TommanCZ/herni-joystick/README.md

# herni-joystick
Maturitní projekt Tomáše Partla v předmětu informatika na Gymnáziu Jana Keplera.
