TommanCZ/herni-joystick/dokumentace.pdf

# GYMNASIUM JANA KEPLERA

### Parléˇrova 2/118, 169 00 Praha 6

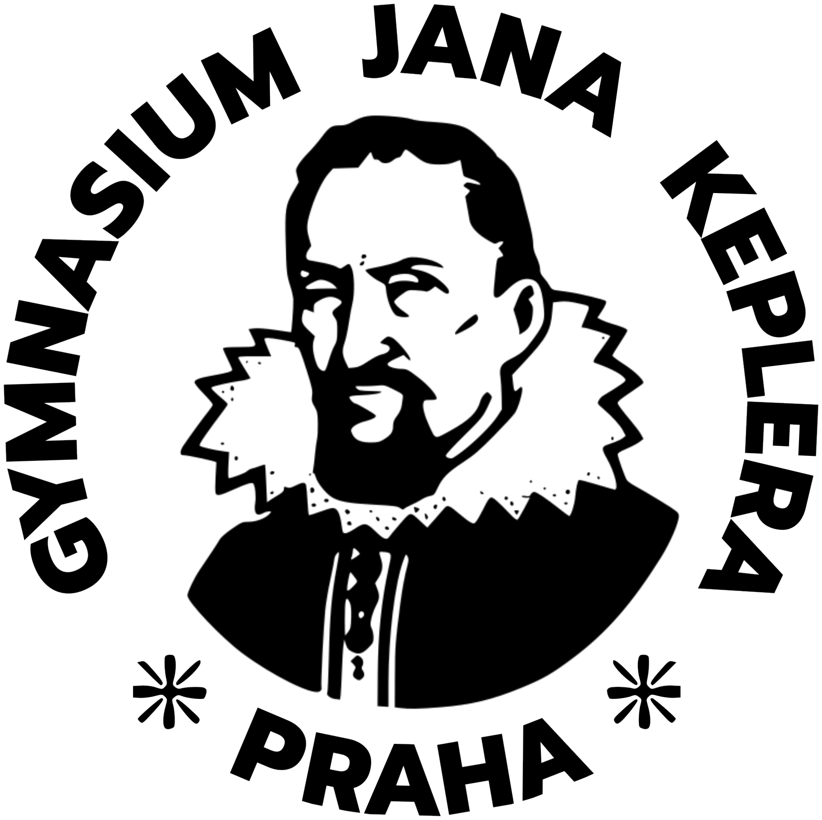
[picture p1: figure]

# Název maturitní práce

# Maturitní práce

### Autor: Tomáš Partl

### Tˇrída: 4.A

### Školní rok: 2024/2025

### Pˇredmˇet: Informatika

### Vedoucí práce: Emil Miler

### Praha, 2025

# Gymnázium Jana Keplera

## Kabinet informatiky

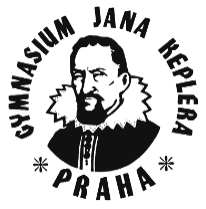
[picture p2: figure]

# ZADÁNÍ MATURITNÍ PRÁCE

- Student | Tomáš Partl
- Třída: | 4. A
- Školní rok: | 2024/2025
- Vedoucí práce: | Emil Miler
- Název práce: | Herní joystick

### - URL repozitáře: https://github.com/TommanCZ/herni-joystick

### Cíle:

Cílem projektu je navrhnout a sestavit joystick, který bude možné připojit k počítači jako USB

### HID zařízení. Tento joystick by měl obsahovat několik tlačítek, aby umožňoval praktické

ovládání, například pro vybírání položek v menu hry či pro použití ve flight simulátorech.

### Plán je, aby zařízení bylo bezdrátové pomocí externího USB modulu s anténou, podobně jako u bezdrátových myší. Konstrukce by měla zahrnovat i vlastní PCB desku, jejíž návrh a

výroba jsou součástí projektu.

## Prohlášení

Prohlašuji, že jsem svou práci vypracoval samostatnˇe a použil jsem pouze prameny a literaturu uvedené v seznamu bibliografických záznam ˚u. Nemám žádné námitky proti zpˇrístupˇnování této práce v souladu se zákonem ˇc. 121/2000 Sb. o právu autorském, o právech souvisejících s právem autorským a o zmˇenˇe nˇekterých zákon ˚u (autorský zákon) ve znˇení pozdˇejších pˇredpis ˚u.

V Praze dne 3. bˇrezna 2025 | Tomáš Partl

## Podˇekování

Dˇekuji Emilu Milerovi za to, že vedl mou maturitní práci. Dále dˇekuji Tomášovi Partlovi (mému otci), že mˇe jako konstruktér uˇcil dobˇre a efektivnˇe modelovat. Dˇekuji Tomáši Kˇreˇckovi za to, že mˇe nauˇcil minimalizaci velikosti a správnému návrhu tvorby PCB desek. Též dˇekuji Pavlu Strnadovi, že mi dovoli použít jeho technické vybavení k osazení PCB desek. V neposlední ˇradˇe dˇekuji Josefu Liškovi za vnuknutí nápadu na tento projekt svou vˇetou: „zkuste to bez drát ˚u, milý Marconi.“

## Abstrakt

Práce se zaobírá navržením a vytvoˇrením herního joysticku s pomocí bezdrátových technologií. Hlavním cílem projektu bylo vytvoˇrit cenovˇe dostupný a snadno sestavitelný ovládací prvek, který by umožˇnoval domácí výrobu pomocí 3D tisku a využití volnˇe dostupných komponent ˚u. V rámci práce byly zkoumány r ˚uzné hardwarové pˇrístupy, pˇriˇcemž byly testovány varianty založené na mikrokontrolérech Atmega328p a ATmega32u4. Finální ˇrešení bylo postaveno na platformˇe ESP32S3, která díky hardwarové podpoˇre USB a Bluetooth nabízí vyšší spolehlivost a snadnˇejší implementaci, než ˇrešení s externím modulem s anténou.

Projekt zahrnuje jak vývoj napájecí sítˇe s využitím dvou AAA baterií, step-up mˇeniˇce a stabilizátoru TS1117, tak návrh PCB deky. Mechanická ˇcást joysticku byla navržena s d ˚urazem na jednoduchost, robustnost a jednoduchou sestavitelnost, pˇriˇcemž byla rozdˇelena do tˇrí ˇcástí (základny, tˇela a hlavy). Je vytvoˇrena primárnˇe 3D tištˇenými díly a standardními mechanickými souˇcástkami jako šrouby, ložiska, pružiny apod.

Výsledkem projektu je funkˇcní prototyp herního joysticku, který dokazuje, že je možné takové zaˇrízení v domácím prostˇredí vyrobit.

Klíˇcová slova

joystick, 3D tisk, Bluetooth, mikrokontrolér

## Abstract

The project deals with the design and creation of a gaming joystick using wireless technologies. The main goal of the project was to create an affordable and easy to assemble control that would allow home production using 3D printing and the use of freely available components. Different hardware approaches were explored in the work, with variants based on Atmega328p and ATmega32u4 microcontrollers being tested. The final solution was based on the ESP32S3 platform, which offers higher reliability and easier implementation than a solution with an external antenna module, thanks to its hardware support for USB and Bluetooth.

The project involves both the development of a power network using two AAA batteries, a step-up converter and a TS1117 regulator, and the design of a PCB blanket. The mechanical part of the joystick was designed with an emphasis on simplicity, robustness and ease of assembly, and was divided into three parts (base, body and head). It is made primarily with 3D printed parts and standard mechanical components such as screws, bearings, springs, etc.

The result of the project is a working prototype of a gaming joystick, proving that it is possible to produce such a device in a home environment.

Keywords

Joystick, 3D printing, Bluetooth, Microcontroller

# Obsah

1 Teoretická ˇcást | 3
2 Implementace | 5
3 Technická dokumentace | 7
Závˇer | 17
Seznam použité literatury | 19
Seznam obrázk ˚u | 21

# 1. Teoretická ˇcást

I pˇresto, že je létaní ve videohrách stále ˇcastˇejší a dostupnˇejší, poˇrízení herního joysticku m ˚uže být stále pomˇernˇe drahou záležitostí. Levnˇejší modely se obvykle pohybují v ˇrádu pˇriližnˇe 1200Kˇc, zatímco kvalitnˇejší varianty bývají výraznˇe dražší. Cílem této maturitní práce je vyvinout herní joystick, který lze snadno pˇripojit k poˇcítaˇci jako USB HID zaˇrízení. Souˇcasnˇe je ale cílem dokázat, že výroba takového ovládacího prvku nemusí být nákladná ani složitá. Samozˇrejmˇe je bráno v potaz, že výroba prototypu bude nákladnˇejší než poˇrízení levného modelu z obchodu s elektronikou, a že výsledný produkt nemusí dosahovat kvality komerˇcních zaˇrízení. Pˇresto se doufá, že za využití tˇreba alternativního zp ˚usobu výroby – napˇríklad použitím již vyrobené desky namísto na míru vyrobené PCB desky – bude výsledný joystick levný, snadno dostupný a jednoduše sestavitelný.

Joystick by mˇel mít nˇekolik klíˇcových vlastností. Za prvé by mˇel obsahovat všechno potˇrebné ovládání, aby byl samostatnˇe použitelný (napˇríklad základní tlaˇcítka A, B, X, Y, minimálnˇe dvˇe osy, apod.). Dále by mˇel být bezdrátový, což zajistí pohodlnou manipulaci a umožní, aby v tomto ohledu odpovídal trendu moderních bezdrátových HID zaˇrízení, jako jsou bezdrátové myši a ovladaˇce.

Tento projekt je vhodné rozdˇelit do tˇri ˇcásti. První ˇcást se zamˇeˇruje na softwarovou stránku, kde je tˇreba vyvinout vhodný kód a využít odpovídající knihovny pro ovládání joysticku. Druhá ˇcást se vˇenuje hardwaru. Zahrnuje tvorbu PCB desek, navázání propojení uvnitˇr samotného joysticku a integraci jednotlivých technologií. Tˇretí, závˇereˇcná ˇcást se zabývá modelováním výsledného zaˇrízení. Tento postup odpovídá optimálnímu vývojovému procesu pro realizaci celého projektu.

Pˇrí návrhu a realizaci projektu bylo nutné ˇcelit nˇekolika klíˇcovým technickým výzvám. Obtížná byla tvorba PCB desek, protože tv ˚urce m ˚uže zjistit, zda deska skuteˇcnˇe funguje, až týden nebo dva po vytvoˇrení. Dále byla nároˇcná tvorba 3D model ˚u, jelikož ne všechny díly mají dobˇre dostupné 3D modely. Postupovat se tedy nˇekdy muselo metodou pokus omyl – vytvoˇrit díl, vytisknout díl na 3D tiskárnˇe, vyzkoušet díl. Nejvˇetší technickou výzvou bylo zajištˇení bezdrátového spojení mezi poˇcítaˇcem a joystickem. P ˚uvodní plán pˇredpokládal využití externího USB modulu s anténou a mikrokontrolér ˚u typu ATmega. Nejprve se experimentovalo s kombinací dvou Atmega328P, technologie V-USB a modulu NRF24L01+, následnˇe pak s mikrokontrolérem Atmega32U4 ve stejném uspoˇrádání. Ani jeden z tˇechto pˇrístup ˚u nevedl k uspokojivému výsledku, což vedlo k hledání alternativního ˇrešení.

Nakonec bylo rozhodnuto o využití ESP32 a technologie Bluetooth. I pˇresto, že se toto ˇrešení odklonilo od p ˚uvodního plánu a zadání využití externího USB modulu, ukázalo se být nejen výraznˇe praktiˇctˇejší, ale i technologicky jednodušší. Použité technologie jsou podrobnˇeji rozebrány v tˇretí ˇcásti dokumentace.

Cílem bylo nejen aplikovat teoretické znalosti v oblasti elektroniky a programování, ale také nabýt nové zkušenosti a dovednosti. Projekt by mˇel pˇrispˇet k rozvoji amatérské ovládací techniky a dokázat, že i amatér je schopen vyrobit vlastní elektronické zaˇrízení, aniž by byl závislý na trhu s elektronikou, jenž v oblasti herního pr ˚umyslu ˇcasto nutí uživatele kupovat pˇredražená zaˇrízení s funkcemi, které nemusí pˇresnˇe vyhovovat jejich potˇrebám.

Tento projekt je urˇcen primárnˇe pro nenároˇcné hráˇce, kterým nevadí si vyrobit produkt dle návodu, nebo se jím inspirovat. Naopak není zamˇeˇren na nároˇcné uživatele vyžadující maximální kvalitu a preciznost, protože zaˇrízení není na úrovni moderní herní elektroniky.

Teoretická ˇcást

# 2. Implementace

Pˇri hledání podobných projekt ˚u bylo prostudováno mnoho online zdroj ˚u, repozitáˇr ˚u a diskuzních fór, kde nadšenci prezentují své domácí verze herních ovladaˇc ˚u. Naprostá vˇetšina tˇechto projekt ˚u spadá do kategorie ovladaˇc ˚u založených na platformˇe Arduino Micro. Pro realizaci tˇechto projekt ˚u je to v zásadˇe rozumná volba. Desky s mikrokontrolerem Atmega32U4 (napˇríklad Arduino Micro ˇci Arduino Leonardo) disponují hardwarovou podporu USB. To umožˇnuje využití ˇrady existujících knihoven, jako je napˇríklad oblíbená Arduino Joystick Library od Matthew Heironimus [2] nebo knihovna LUFA od Deana Camera [1], která nepracuje s platoformou Arduino, ale pˇrímo s platformou AVR, což jí umožˇnuje být více efektivní a výraznˇe více nastavitelnou.

Pro první pokusy však bylo rozhodnuto ˇrešení s ˇcipem ATmega32U4 vynechat. Zaprvé byla požadovaná vˇetší kontrola nad implementací USB, což umožˇnovala knihovna V-USB. Zadruhé se zdálo jako dobrá volba využít modul nRF24L01+, u nˇehož dle informací z fór mívají lidé ˇcasto problém s kompatibilitou s deskami, které obsahují mikrokontrolér ATmega32U4. Cílem bylo tedy pˇredejít tˇemto problém ˚um. Dalším významným faktorem byla dostupnost. Mikrokontrolér ATmega32U4 je v porovnání s jinými ˇcipy, jako jsou Atmega328P nebo ESP32, výraznˇe ménˇe dostupný.

Mezi vyhledanými projekty se mnoho soustˇredilo pouze na mechanickou ˇcást joystick ˚u. Ve srovnání s nˇekterými z tˇechto projekt ˚u tento herní joystick vzhledovˇe zaostává, napˇríklad v porovnání s HO-TAS joystickem od uživatele rdbeerman [3]. Jeho design kopíruje vzhled stíhaˇcky F-14 a disponuje vlastním kompaktním gimbalem. Rád bych však zd ˚uraznil, že cílem tohoto projektu nebylo intenzivnˇe se vˇenovat vzhledové stránce výsledného modelu – cílem bylo se primárnˇe zamˇeˇrit primárnˇe zamˇeˇrit na elektronickou sestavu. Mým zámˇerem navíc nebylo replikovat komplexní 3D design HOTAS joystick ˚u, ale vytvoˇrit jednoduchý, robustní a snadno dostupný model, který lze snadno vyrobit s pomocí 3D tiskárny a nˇekolika bˇežnˇe dostupných díl ˚u.

Pokud jde o technologii snímání úhl ˚u, vˇetšina projekt ˚u (pokud nevyužívá již hotové mini joysticky) používají jednu ze dvou možností. První z nich je snímání úhlu pomocí potenciometr ˚u, což je zp ˚usob, který byl zvolen pro tento projekt. Druhou možností je využití senzor ˚u založených na Hallovˇe efektu. Tento zp ˚usob se rozhodl využít napˇríklád vývojáˇr Tom Stanton [4]. Hallovy senzory mají mnoho výhod, mají napˇríklad schopnost pˇresnˇe snímat malé úhly, šetˇrí místo a eliminují náchylné pohyblivé ˇcásti. V tomto projektu byly upˇrednostnˇeny potenciometry, jelikož bývají obecnˇe robustnˇejší, dostupnˇejší a levnˇejší.

Další projekt, který je vhodné zmínit a porovnat, je bezdrátový joystick od vývojáˇre taifur [5]. Tento projekt využívá mikrokontrolér ATmega328P s 315Mhz vysílaˇcem na jedné stranˇe a Arduino Micro na stranˇe pˇrijímaˇce. P ˚uvodnˇe se zdálo, že je volba vysílaˇce nRF24L01+ lepší díky nízké latenci, vysoké pˇrenosové hustotˇe dat a nízké spotˇrebˇe energie. Pozdˇeji se však ukázalo, že toto ˇrešení nese své problémy a že zmˇena vysílaˇce na obdobný modul by mohla být jedním z možných ˇrešení. Nakonec však bylo rozhodnuto, že koneˇcné ˇrešení s ESP32 a Bluetooth spojením pˇredstavuje výhodnˇejší a praktiˇctˇejší variantu.

Celkovˇe bylo zjištˇeno, že neexistuje pˇríliš mnoho projekt ˚u, které by se zamˇeˇrovaly na pˇresnˇe stejné aspekty jako tento projekt. Projekty se vˇetšinou zamˇeˇrují pouze na urˇcitý aspekt, a to bud’ na elektronickou ˇcást, nebo pouze na model. Kromˇe projektu od uživatele ¨taifur existuje ještˇe nˇekolik projekt ˚u, které se pokoušely vytvoˇrit bezdrátový gamepad a to i s pomocí ˇrešení s ESP32, které bylo nakonec zvoleno pro tento projekt. Nicménˇe se nepodaˇrilo najít projekt, který by pokrýval

Implementace

komplexnost bezdrátového joysticku, který je navržen v tomto projektu. V tomto ohledu je tento projekt unikátní a snad se mu alespoˇn ˇcásteˇcnˇe podaˇrí zaplnit tuto mezeru.

# 3. Technická dokumentace

## 3.1 Software

### 3.1.1 V-USB

V rámci tohoto projektu bylo rozhodnuto nejprve využít ˇrešení založené na dvou mikrokontrolérech ATmega328P s USB HID komunikací zajištˇenou s využitím knihovny V-USB. Jako komunikaˇcní modul byl zvolen nRF24l01+ s knihovnou nRFLite.

Knihovna V-USB je oproti mnoha jiným AVR USB knihovnám unikátní svým ˇcistˇe softwarovým ˇrešením. Nepodporuje vyšší rychlosti USB, jako je napˇríklad USB 2.0 a novˇejší, které zvládá ATmega32U4 díky vestavˇenému USB. Na rozdíl od jiných knihoven však umožˇnuje implementaci USB komunikace i na mikrokontrolérech bez hardwarového USB, jako je ATmega328P. Využívá k tomu pouze standardní GPIO piny, pˇriˇcemž alespoˇn jeden z datových pin ˚u (D+ nebo D-) musí být interrupt pin. Knihovna je optimalizována pro nízké nároky na flash pamˇet’ i RAM.

Druhá knihovna nRFLite poskytuje jednoduché a efektivní API pro komunikaci pomocí bezdrátového modulu nRF24L01. Je navržena tak, aby minimalizovala své nároky na RAM. Oproti rozsáhlejším knihovnám, jako je RF24, je kompaktnˇejší a jednodušší, pˇriˇcemž stále umožˇnuje spolehlivý pˇrenos dat mezi zaˇrízeními. Knihovna využívá SPI rozhraní pro komunikaci s nRF24L01 a podporuje základní nastavení adres, kanál ˚u a pˇrenosových režim ˚u, které je omezenˇejší oproti RF24, ale pro tento projekt bohatˇe dostaˇcující. Jelikož je knihovna nRFLite závislá na platformˇe Arduino, musely být soubory Arduino-core zaˇrazeny do projektu.

Pro kompilaci byly použity nástroje avr-gcc a avr-g++, finální firmware byl nahráván pomocí programu avrdude s pomocí programátoru UBSasp.

Výbˇer tˇechto knihoven se z zpoˇcátku zdál atraktivní z nˇekolika d ˚uvod ˚u. Zaprvé umožnil velkou kontrolu nad USB komunikací, protože použitím V-USB bylo možné upravovat mnoho nastavení, jako USB deskriptor a reporty. Další významnou výhodou byl fakt, že ATmega328P je velmi dostupný a cenovˇe nenároˇcný ˇcip.

Bohužel pˇri vývoji bylo objeveno nˇekolik zásadních technických problém ˚u, které vyplývaly pˇredevším z nároˇcnosti ˇcasování. V implementaci V-USB na platformˇe ATmega328P je totiž kritické dodržení ˇcasových limit ˚u, a i malé odchylky vedly ke kolizím v USB komunikaci.

Velký problém tedy pˇredstavovala integrace bezdrátového modulu pomocí knihovny nRFLite. Ukázalo se, že nRFLite je velmi citlivá na pˇresné ˇcasování. Kombinace pˇrísných ˇcasových požadavk ˚u V-USB a nRFLite znamenala, že ˇcip ATmega328P musel najednou zvládat dvˇe ˇcasovˇe nároˇcné úlohy, což vedlo k selháním. Pˇres pokusy upravit nRFLite knihovnu, aby ulehˇcila funkci V-USB skrz opakované poolování v nˇekterých ˇcástech jejího kódu s dˇelšími ˇcekacími intervaly, se nepodaˇrilo kolize eliminovat. Hlavní problém pravdˇepodobnˇe spoˇcíval v interruptech, které V-USB používá – mikrokontrolér nedokázal spolehlivˇe obsloužit obˇe úlohy najednou.

Nakonec byla práce na tomto ˇrešení ukonˇcena, jelikož ˇcip ATmega328P s V-USB a nRFLite nebylo možné považovat za dostateˇcnˇe spolehlivý na to, aby bylo možné pˇredpokládat postupné vyˇrešení

Technická dokumentace

tohoto problému. Pˇresto toto ˇrešení dalo projektu cenné zkušenosti, zejména v oblasti implementace USB komunikace na ATmega mikrokontrolérech.

3.1.2 32U4

Další fáze projektu se zamˇeˇrila na využití mikrokontroléru ATmega32U4 ve spojení s knihovnou LUFA a modulem nRF24l01+ na stranˇe pˇrijímaˇce. Vysílaˇc v joysticku založený na ATmega328P mohl z ˚ustat stejný. Využití ATmega32U4 pˇrináší nˇekolik potenciálních výhod, hlavnˇe nativní hardwarovou podporu USB, která umožˇnuje použití rychlejší USB 2.0 pˇri plné rychlosti, a to bez zbyteˇcné zátˇeže ˇcipu. Knihovna LUFA, což je open-source framework pro vývoj USB zaˇrízení na platformˇe AVR, nabízí sadu nástroj ˚u pro implementaci USB komunikace, vˇcetnˇe podpory vlastních USB deskriptor ˚u a report ˚u, ˇcímž umožˇnuje precizní definici chování zaˇrízení.

V rámci tohoto ˇrešení byl opˇet zvolen modul nRF24l01+ jako modul pro bezdrátovou komunikaci. Pˇrestože se spolehlivˇe osvˇedˇcil na deskách s ATmega328P, pˇri pˇrechodu na Atmega32U4 se vyskytly problémy s komunikací a to i pˇri využití stejného programu. Pˇri testech provádˇených v prostˇredí Arduino IDE bylo opakovanˇe zjištˇeno, že mikrokontrolér nˇekdy neodesílal ani základní zprávy pˇres sériový port, pokud byl program obsahující knihovny pro nRF24 naˇcten. Další pokusy, realizované mimo prostˇredí Arduino IDE s využitím pouze Arduino-core a knihovny nRFLite ukázaly, že zaˇrízení po odeslání nˇekolika packet ˚u bˇehem nˇekolika sekund zaˇcalo hlásit chyby pˇri pˇrenosu dat. Je vhodné zmínit, že testy byly provádˇeny na desce Arduino Leonardo, jelikož varianta ATmega32U4-PU není dostupná. Pro kompilaci bylo zase použito nástroj ˚u avr-gcc a avr-g++ a pro nahrávání program avrdude s programátorem USBasp.

Hledání ohniska problému je zde ponˇekud složitˇejší. Potíže je možné vysvˇetlit nˇekolika zp ˚usoby. Hardwarové rozdíly mezi Atmega328p a Atmega32U4 mohou mít vliv na zpracování ˇcasovˇe kritických operací – zatímco ATmega328P byla schopna spolehlivˇe zvládat nároˇcné ˇcasování potˇrebné pro obsluhu jak V-USB, tak modul ˚u nRF24l01+, ATmega32U4 má odlišné mechanismy pˇrerušení a ˇcasování, což mohlo vést ke konflikt ˚um pˇri komunikaci s modulem. Také není vylouˇceno, že byl problém ve špatné konfiguraci knihoven na ˇcipu Atmge32U4 a další testovaní by vedlo k jejich úspˇešnému zprovoznˇení.

Jelikož se ˇrešení ukázalo jako problematické a nedosáhlo požadované stability bezdrátové komunikace, v d ˚usledku tˇechto pokus ˚u bylo rozhodnuto hledat jiné ˇrešení. I pˇresto, že tato fáze projektu byla neúspˇešná, ukázala, že pˇri implementaci USB zaˇrízení ve spojení s bezdrátovou komunikací je tˇreba brát v úvahu specifické hardwarové rozdíly mezi mikrokontroléry.

### 3.1.3 ESP32S3

Poslední fáze softwarového ˇrešení se zamˇeˇrila na pˇrechod z mikrokontrolér ˚u ATmega na ˇcip ESP32, konkrétnˇe variantu ESP32S3, která umožˇnuje pˇrímé bezdrátové spojení s poˇcítaˇcem – prostˇrednictvím Bluetooth. Tento pˇrístup eliminuje nutnost použití samostatného externího modulu pro pˇríjem dat z joysticku, ˇcímž se výraznˇe zjednodušuje hardware a snižuje celková složitost systému. Integrovaná podpora Bluetooth u ESP32S3 pˇrináší požadovanou bezdrátovou konektivitu a umožˇnuje efektivní komunikaci bez nutnosti dodateˇcných komponent ˚u.

Pro implementaci Bluetooth komunikace byla využita knihovna ESP32-BLE-Gamepad vývojáˇre lem-

Technická dokumentace

mingDev, která je dostupná na GitHubu. Tato knihovna umožˇnuje, aby ˇcip ESP32 vystupoval jako standardní HID gamepad. I když tato knihovna neposkytuje tak detailní kontrolu nad komunikací jako ˇrešení založená na V-USB, výraznˇe zjednodušuje vývojový proces a umožˇnuje rychlé prototypování funkˇcního zaˇrízení. Díky tomuto pˇrístupu se podaˇrilo zkrátit dobu vývoje a snížit nároky na detailní konfiguraci komunikace.

Pˇri implementaci bylo nutné ˇcelit také problém ˚um spojeným s kompatibilitou HID zaˇrízení mezi operaˇcními systémy. Zatímco systémy založené na Linuxu disponují univerzálním ovladaˇcem, který umožˇnuje snadné rozpoznávání a konfiguraci vstupních zaˇrízení, operaˇcní systém Windows využívá rozhraní XInput optimalizované pro herní ovladaˇce. Tento pˇrístup vede k situacím, kdy Windows nemusí akceptovat nˇekteré konfigurace vstup ˚u, jež jsou bez problém ˚u rozpoznány v Linuxu. Rozdílné zp ˚usoby zpracování HID protokolu mezi tˇemito systémy tak pˇredstavovaly významnou výzvu, kterou bylo tˇreba ˇrešit úpravou konfigurací pro zajištˇení správné funkˇcnosti na obou platformách.

P ˚uvodnˇe se o ESP32S3 pˇremýšlelo jako o zaˇrízení, které má hardwarovou podporu USB. Zároveˇn má podporu knihoven pro modul nRF24l01+, jako nRFLite nebo RF24. To z nˇej dˇelalo ideálního kandidáta pro další pokusy. Po uvážení se zdálo zbyteˇcné použít ESP32S3 tímto zp ˚usobem, jelikož lze podobných výsledk ˚u dosáhnout využitím schopnosti ESP32 využívat Bluetooth, což eliminuje potˇrebu mít systém s dvˇema deskami.

Celkovˇe lze ˇríci, že pˇrechod na ˇrešení s ESP32S3 a využití knihovny ESP32-BLE-Gamepad je efektivnˇejší, jednodušší, ale i levnˇejší. Nevyužití komunikaˇcního modulu jako nRF24l01+ dˇelá systém spolehlivˇejší a snižuje latenci.

Co se týˇce samotného finálního programu, ten je ve výsledku relativnˇe jednoduchý. Skládá se z dvou hlavních funkcí a to getAxis a setButtons. SetButtons se stará o zajištˇení stavu tlaˇcítek spoleˇcnˇe se systémem pˇrepínacího tlaˇcítka. Funkce getAxis se stará a správné pˇreˇctení os a to i v pˇrípadˇe zmenšeného úhlu potenciometru. Zároveˇn se stará o ˇrešení nulové zóny joysticku a digitální zjemˇnování výchylek pˇri mˇeˇrení.

## 3.2 Hardware

Co se týˇce sekce s hardwarem, myslím, že je vhodné ji rozdˇelit na tˇri sekce. První se bude zabývat designem elektrické sítˇe v joysticku, druhá popíše použité ovládací prvky a tˇretí se bude podrobnˇeji zaobírat designem navržených a vyrobených desek. Návrh a výroba hardwaru byla nejnároˇcnˇejší ˇcástí tohoto projektu.

### 3.2.1 Napájení

Pro správné fungování joysticku musela být správnˇe navržena napájecí sít’. Pro napájení jsou využity dvˇe tužkové AAA baterie, které jsou díky svým malým rozmˇer ˚um vhodnˇejší než standardní AA ˇclánky. U baterií celá napájecí sít’ zaˇcíná. Jsou pˇripojeny k step-up mˇeniˇci MT3608. Tento modul zvyšuje napˇetí z baterií na úroveˇn, kterou následnˇe stabilizuje regulátor TS1117 na 3.3V. P ˚uvodnˇe bylo v plánu využít klasiˇctˇejší AMS1117, ale v d ˚usledku komplikací s dodavatelským ˇretˇezcem bylo ˇrešení pˇrepracováno a zvolen byl TS1117, který se od AMS1117 neliší zásadnˇe.

Technická dokumentace

Mezi MT3608 a bateriemi je integrován pˇrepínaˇc, který umožˇnuje úplné odpojení napájení celého joysticku. Na mˇeniˇci MT3608 jsou dle doporuˇcení napájeny dva 100nF kondenzátory na vstupu a výstupu pro redukci šumu. Ze zdroje MT3608 vedou napájecí dráty do centrální ˇrídicí desky, odkud je napˇetí sníženo na 3.3V pomocí regulátoru TS1117 a následnˇe distribuováno do zbytku joysticku. Tento pˇrístup zaruˇcuje, že všechny ˇcásti zaˇrízení dostávají stabilní a konzistentní napˇetí, což je klíˇcové pro správnou funkci ovládacích prvk ˚u, které využívají dˇeliˇce napˇetí. Centralizované rozvedení napájení z ˇrídicí desky navíc usnadˇnuje údržbu a pˇrípadné budoucí úpravy systému, což je zvláštˇe výhodné pro tento manuálnˇe vyrábˇený projekt.

P ˚uvodní návrhy desek, které mˇely být napájeny pomocí USB, využívaly stejného lineárního regulátoru. To bylo výhodné kv ˚uli menšímu poˇctu r ˚uzných díl ˚u v soustavˇe, což zjednodušovalo celý výrobní proces.

### 3.2.2 Ovládací prvky

V tomto projektu je použita kombinace šesti tlaˇcítek typu KLS7-P8.0X8.0B a malého joysticku KY-023, pˇriˇcemž ovládací prvky jsou uspoˇrádány do nˇekolika funkˇcních skupin. Na horní ovládací lištˇe se nachází malý joystick spolu se ˇctyˇrmi tlaˇcítky, což zajišt’uje hlavní interakci uživatele se zaˇrízením. Dále je jedno tlaˇcítko umístˇeno pod horní ˇcástí joysticku, kde slouží napˇríklad pro akce jako stˇrelba, a jedno tlaˇcítko je umístˇeno na boku joysticku – funguje jako pˇrepínaˇc sady tlaˇcítek. Díky tomuto uspoˇrádání bude finální implementace generovat až deset signál ˚u místo p ˚uvodních šesti, což výraznˇe rozšiˇruje možnosti ovládání.

Tlaˇcítka KLS7-P8.0X8.0B byla zvolena pˇredevším pro jejich dostateˇcnou velikost, která zajišt’uje jejich použití bez nutnosti navrhovat vlastní PCB desku pro ovládací prvky na horní lištˇe. Mini joystick KY-023, který p ˚uvodnˇe sloužil pouze jako prototyp pro testování, se nakonec stal souˇcástí finálního designu. Je urˇcen jako pomocný ovládací prvek k dvˇema hlavním ovládacím osám, jejichž funkˇcnost je zajištˇena s pomocí dvou potenciometr ˚u. Tyto potenciometry fungují jako dˇeliˇce napˇetí. Jejich výstup mˇeˇrí kontroler na deskách a urˇcuje úhel. Malý joystick KY-023 pˇricházi s vlastním tlaˇcítkem, které je integrováno do jeho designu. To ale v tomto projektu nebylo využito. Tomu tak je primárnˇe kv ˚uli tomu, že se p ˚uvodnˇe poˇcítalo s jiným malým joystickem, který toto tlaˇcítko nemˇel.

V pˇríští verzi projektu by mohlo být výhodné nahradit joystick KY-023 plošným joystickem, který využívají pˇríruˇcní herní konzole jako nebo Nintendo Switch nebo PSP. Takové ˇrešení by bylo prostorovˇe ménˇe nároˇcné a pro uživatele by mohlo být pˇríjemnˇejší.

### 3.2.3 PCB desky

V rámci návrhu PCB desek byly vyvinuty ˇctyˇri varianty. Dvˇe desky mˇely p ˚uvodnˇe sloužit jako pˇrijímaˇce, které se pˇripojují k poˇcítaˇci s pomocí USB, zatímco další dvˇe mˇely být použity v joysticku jako vysílaˇce. Poˇcáteˇcní verze desek, které mˇely být pˇripojeny k poˇrítaˇci, nefugovaly dle oˇcekávání kv ˚uli problém ˚um s vysílaˇcem nRF24l01+. Z tohoto d ˚uvodu byla navržena a vyrobena ˇctvrtá deska s platformou ESP32S3, která umožˇnuje bezdrátové pˇripojení k poˇcítaˇci bez externího modulu s anténou a to prostˇrednictvím Bluetooth.

Z celkového poˇctu ˇctyˇr navržených desek byly úspˇešnˇe vyrobeny tˇri. Funkˇcnost desky s ESP32S3 byla potvrzena a využívá se ve vyrobeném prototypu. P ˚uvodní deska, která mˇela být v joysticku,

Technická dokumentace

vyrobena byla, ale dosud nebyla testována, nicménˇe by mˇela fungovat dle oˇcekávání. Pro tento projekt ale již není relevantní.

Pˇrijímací deska s Atmega328P

Navrhovaná pˇrijímací deska s mikrokontrolérem Atmega328p nebyla nakonec dokonˇcena ani vyrobena, jelikož se ukázalo, že kombinace technologie V-USB a modulu nRF24 nefunguje. K dokonˇcení desky by bylo tˇreba zmˇenit oscilátor na 12MHz z 16Mhz a dodat nˇekolik 100n filtraˇcních kondezátor ˚u k napájecím pin ˚um mikrokontroleru a pˇrípadnˇe ICSP konektor.

V-USB totiž vyžaduje minimální frekvenci ˇcipu alespoˇn 12 MHz, což by mˇelo být ˇrešeno použitím externího 12 MHz krystalu. Vyšší frekvence by nemˇely být zvoleny, protože mirkokontroler je napájený stabilizovaným napˇetím 3.3 V, pˇriˇcemž výrobce zaruˇcuje stabilní fungování ˇcipu pouze do 12 MHz pˇri tomto napˇetí. Deska je tímto napájena, jelikož USB data piny fungují na napˇetí 3.3V a pˇri stejném napájecím napˇetí funguje modul nRF24l01.

Deska je dále vybavena USB A konektorem, který je zapojen dle doporuˇcení dokumentace V-USB (obr. 3.1). Pro úˇcely bezdrátové komunikace je integrován modul nRF24.

Zmˇeny nakonec nebyly na desce provedeny, jelikož se upustilo od využití tohoto ˇrešení a zdálo se zbyteˇcné tuto nefunkˇcní koncepci opravovat.

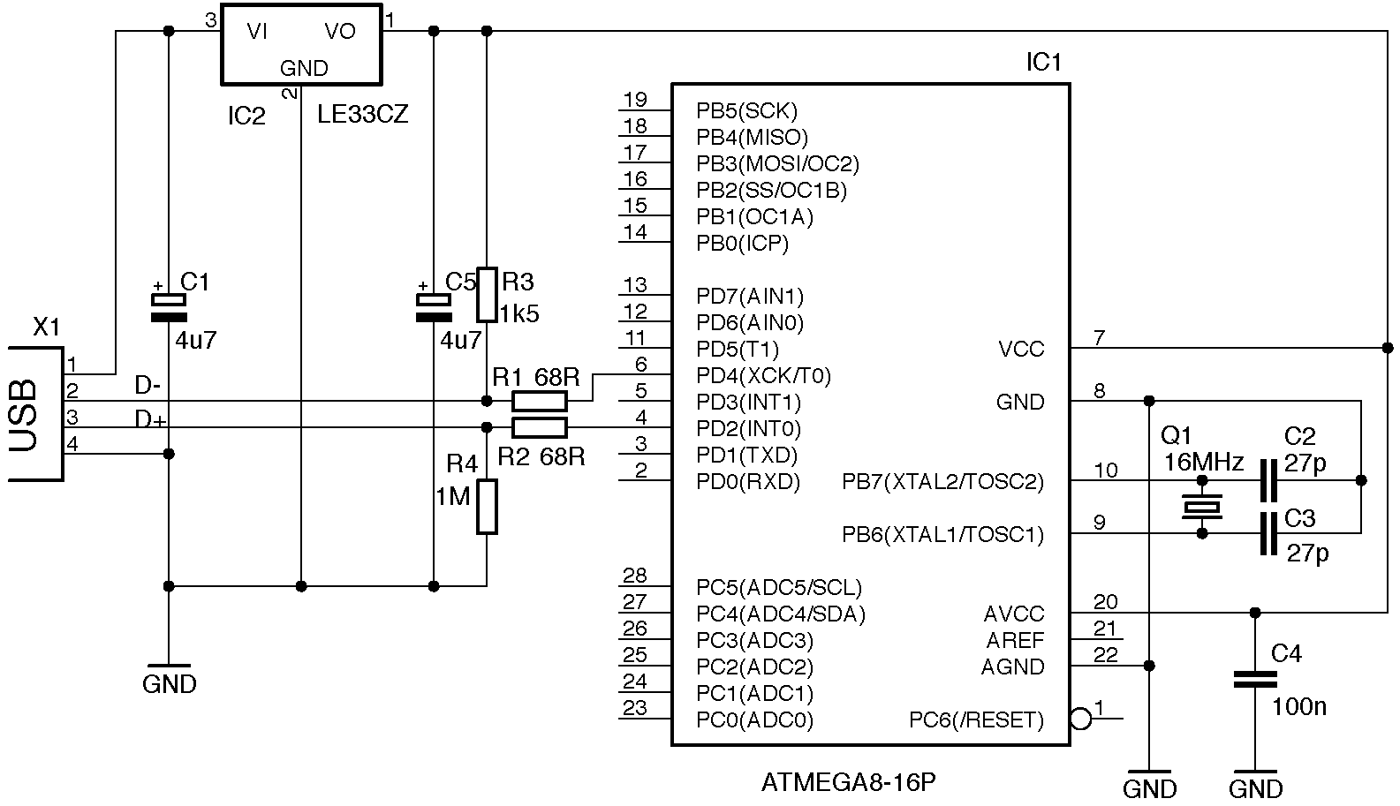
[picture p3: figure]

Obrázek 3.1: popis zapojení USB s pomocí regulátoru napˇetí dle dokumentace V-USB

Vysílací deska s Atmega328P

P ˚uvodní deska urˇcená pro joystick byla navržena pro snímání stavu tlaˇcítek, malého joysticku KY-023 a dvou potenciometr ˚u a následný pˇrenos tˇechto dat transcieverem nRF24l01+. Deska využívá mikrokontrolér Atmega328P. Jako clock signál je využit interní oscilátor s frekvencí 8 MHz.

Technická dokumentace

Deska disponuje pˇeti 2-pinovými JST-XH konektory a dvˇema 4-pinovými JST-XH konektory, jejichž rozložení odpovídá p ˚uvodnímu designu. Pˇet 2-pinových konektor ˚u je urˇceno pro:

- Pˇripojení baterie skrz step-up mˇeniˇc na desku
- Pˇripojení ovládacích prvk ˚u na horní lištˇe hlavy joysticku k zemi a 3.3V
- Pˇrenos signál ˚u z modulu joysticku KY-023
- Pˇrenos signálu z tlaˇcítka ˇcíslo 5
- Pˇrenos signálu z tlaˇcítka ˇcíslo 6

Co se týˇce 4-pinových JST-XH konektor ˚u, jeden z nich vede k ovládacím tlaˇcítk ˚um umístˇeným na horním panelu. Druhý 4-pinový konektor slouží pro propojení s dolními potenciometry, které poskytují analogové signály pro snímání os X a Y, pˇriˇcemž konektor zároveˇn zajišt’uje napˇetí 3.3V a spoleˇcnou zem.

Dále je deska vybavena šesti ICSP header piny (napájení, zem, MOSI, MISO, SCK a RESET), které umožˇnují programování mikrokontroléru pomocí externího programátoru (napˇríklad USBasp).

Desky obsahují 4 kondenzátory. Dva z nich – s hodnotou 10 µF – slouží pro filtraci šumu a vyrovnávání výkyv ˚u na vstupu a výstupu regulátoru TS1117, další dva – s hodnotou 100 nF – slouží k filtraci vysokofrekvenˇcního šumu u napájecích pin ˚u mirkokontroleru. Dále deska obsahuje 2 rezistory o hodnotách 470Ω, které zajišt’ují správný proud pro LED diody na pinech PD6 a PD7.

Funkˇcnost prototypu této desky byla ovˇeˇrena na breadboardu. Poté byla deska vyrobena a manuálnˇe osazena, ale její funkˇcnost nebyla otestována, jelikož vývoj této desky nebyl pozdˇeji již prioritou. Pˇredpokládá se, že navržené ˇrešení by mˇelo být funkˇcní a fungovat tak, jak bylo navrženo.

Pˇrijímací deska s Atmega32u4

Úˇcel této desky byl pˇrijímat data z joystick zaˇrízení a dále posílat tato data do poˇcítaˇce s pomocí USB HID.

Deska je navržena podle datasheetu mikrokontroléru Atmega32u4 (obr. 3.2). Funkˇcnost USB je zajištˇena použitím hardwarové podpory USB na ˇcipu. To lze využít pomocí propojení pin ˚u urˇcených pro USB komunikaci. Mezi datovými piny USB je zaˇclenˇen rezistor o hodnotˇe 22 Ω. Pro stabilizaci napájení je na USB A konektoru umístˇen filtraˇcní kondenzátor o hodnotˇe 10 µF mezi napˇet’ovým vstupem a zemí. Použití tohoto kondenzátoru není vyslovenˇe uvedeno v datasheetu, i pˇresto se kondenzátory mezi napájecími piny používají pro zmírnˇení šumu ze zdroje druhého zaˇrízení.

Napájecí ˇcást USB je dále zajištˇena správným zapojením specifických pin ˚u: piny UVCC a UGND jsou napájecí piny interního 3,3V regulátoru, které zajišt’ují správnou hodnotu napˇetí na datových pinech USB, jelikož datové piny mají odlišnou hodnotu napˇetí od pin ˚u napájecích. Pin UCAP je spojen se zemí pomocí 1 µF kondenzátoru. Na napˇetí 5V je pˇripojen pin VBUS, který slouží k detekci USB zaˇrízení. Pro ochranu mikrokontroleru pˇred poškozením je na USB A pˇripojen ochranný ESD obvod, který zabraˇnuje poškození ˇcipu pˇri nebezpeˇcných výchylkách napˇetí.

Mikrokontrolér ATmega32u4 pracuje pˇri napˇetí 5V a využívá externí krystal o frekvenci 16MHz, který je potˇrebný pro USB komunikaci pˇri vyšších rychlostech. Pro napájení modulu nRF24l01+, který je pˇripojen prostˇrednictvím ISP pin ˚u, se používá regulátor TS1117. Ten využívá dvou 10 µF kondenzátor ˚u pro redukci šumu.

Technická dokumentace

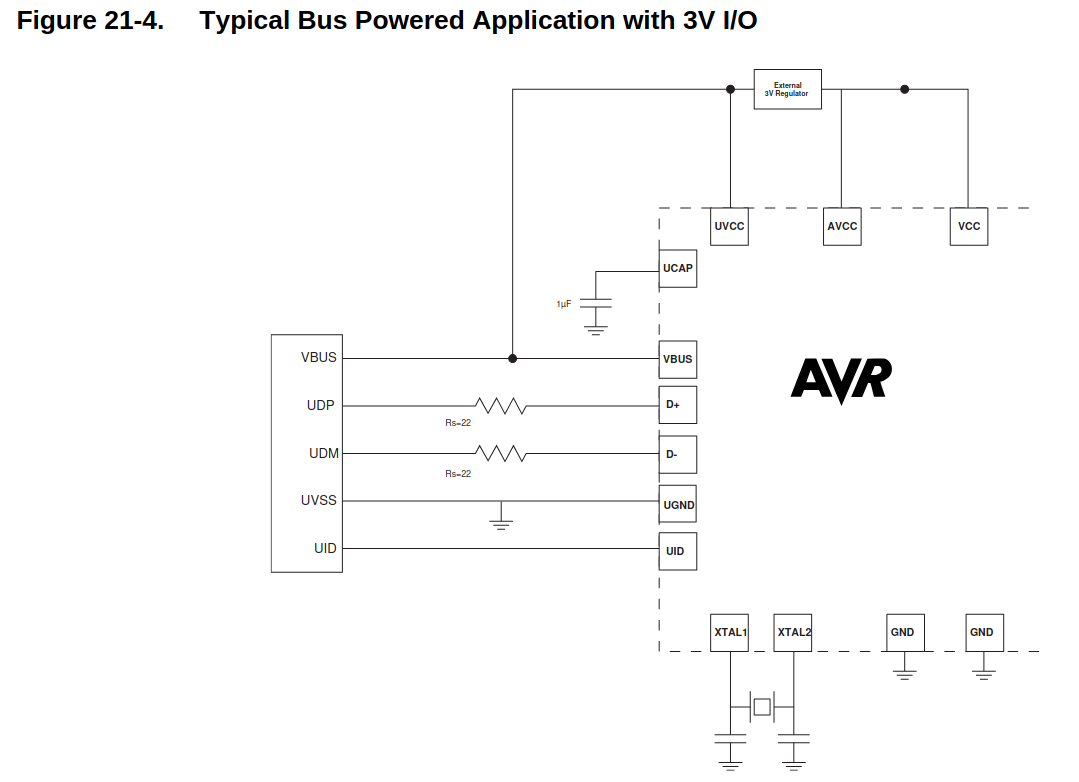
[picture p4: figure]

Obrázek 3.2: popis zapojení USB v datasheetu ATmega32U4

Na desce jsou dále umístˇeny dvˇe LED na pinech PC6 a PC7. Pro zajištˇení správného proudu pro tyto LED jsou použity rezistory o hodnotˇe 1 kΩ. Pro vyrovnání napˇet’ových špiˇcek a odstranˇení šumu jsou použity ˇctyˇri kondenzátory o hodnotˇe 100 nF v blízkosti využitých napájecích pin ˚u. K programování mikrokontroléru slouží šest programovacích ICSP header pin ˚u (napájení, zem, MOSI, MISO, SCK a RESET).

Deska s ATmega32u4 ve finálním ˇrešení nakonec využita nebyla, jelikož nebylo možné zajistit správné fungování modulu nRF24l01+ s ˇcipem ATmega32u4.

Vysílací deska s ESP32S3

Deska ESP32S3 byla vyvinuta jako náhrada za p ˚uvodní desku s ATmega328P. Deska je navržena tak, aby byla kompatibilní s funkcemi p ˚uvodní desky. Obsahuje stejné konektory, stejný systém distribuce napájení, stejné rozloložení dˇer a podobné rozmˇery.

Deska disponuje pˇeti 2-pinovými dvˇema 4-pinovými JST-XH konektory. Ty mají úplnˇe stejné funkce jako konektory u p ˚uvodní desky s Atmega328P popsané v pˇredchozí ˇcásti.

Minimalistický design desky využívá USB podporu kontroleru ESP32S3, což umožˇnuje programování pˇrímo pˇres USB bez potˇreby použití externího USB-to-UART pˇrevodníku. Na desce je dále tlaˇcítko, které propojuje pin GPIO0 se zemí. To se používá pro první programování desky, kdy je tˇreba, ale se deska manuálnˇe pˇrepla do boot módu.

USB napájení spoleˇcnˇe s baterií zásobuje TS1117 modul, který stabilizuje napˇetí na 3.3V. Stabilní napˇetí na 3.3V následnˇe využívá ˇcip ESP32S3, ale i zbytek zaˇrízení. Rozmˇery desky byly ponechány podobné p ˚uvodní desce s ATmega328P, aby nevznikla potˇreba pˇredˇelávat již pˇripravený model joysticku.

Na desce jsou také umístˇeny tˇri kondenzátory. Dva kondenzátory o hodnotˇe 10 µF jsou pˇripojeny u výstupu a vstupu LDO mˇeniˇce a slouží k filtraci a stabilizaci vtupního a výstupního napˇetí, dle doporuˇcení datasheetu dílu. Tímto eliminují šum a vyrovnávají výkyvy. Tˇretí kondenzátor o hodnotˇe 100 nF je umístˇen u napájecího pinu pro filtraci vysokofrekvenˇcního šumu.

Technická dokumentace

Dále jsou na desce použity dva rezistory o hodnotˇe 470 Ω. První z nich je pˇripojen k LED indikátoru, která slouží k ulehˇcení debugování desky. Druhý rezistor je umístˇen na pad, na který m ˚uže být potenciálnˇe pˇripojena extrení LED. Dalším souˇcástí je rezistor o hodnotˇe 10 kΩ, který je zapojen mezi Enable pin a 3,3V. Toto zapojení zajišt’uje stálou funkˇcnost vnitˇrního regulátoru. Pokud by na pinu bylo tlaˇcítko, deska by šla jednoduše odpojit od napájení a restartovat. To se ale v tomto pˇrípadˇe zdálo nadbyteˇcné. Dále je na desce ponechán volný pad, který lze v budoucnosti využít napˇríklad k mˇeˇrení napájecího napˇetí baterie.

### 3.2.4 Seznam díl ˚u

Kompletní seznam využitých díl ˚u je následující: PCB deska, Espressif Systems ESP32-S3-WROOM-1-N16R8 WiFi/Bluetooth Modul (pˇriˇcemž na množství pamˇeti nezáleží, lze použít i varianty s menší pamˇetí), TSMC TS1117BCW33 RPG SOT223, 2x 470Ω rezistor 0603, 10kΩ rezistor 0603, 2x 10uF kondenzátor 0603, 100nF kondenzátor 0603, WEALTHMETAL TD-03XA-T mikrospínaˇc (nebo jiný 6mm x 6mm mikrospínaˇc s rozteˇcí 4.5mm na kontaktech), CONNFLY DS1105-06-B60RX konektor micro USB 2.0 (nebo jiný podobný SMD mikro USB konektor), LUCKY LIGHT S192VC-V1-1B LED 0603. ˇcervená (ˇci jiný SMD 0603 led dioda s podobnými vlastnostmi), 5x JST-XH konektor samice, 2x JST-XH konektor samice.

## 3.3 Modely

Pro výrobu joysticku bylo rozhodnouto použít 3D tiskárnu, jelikož to je pro domácí výrobu nejlevnˇejší a nejsnadnˇejší varianta. 3D tiskárnu má dnes doma témˇeˇr každý kutil. Lze s ní snadno a rychle prototypovat a pˇredˇelávat díly. V pˇrípadˇe, že by tato technologie nebyla pro uživatele dostupná, existuje ˇrada služeb, které na zakázku levnˇe tisknou a zašlou díly.

Samotný joystick se skládá z dvanácti tištˇených díl ˚u. Ty jsou podpovány ˇradou menších souˇcástek, jako jsou šroubky, matky, ložiska, zavitové tyˇce, pružiny apod. Tyto díly je vhodné rozdˇelit na 3 hlavní sekce: na sekci základny, který obstarává vˇetšinu mechaniky, na sekci tˇela, z které se rozvádí veškeré drátování, a na sekci hlavy, na které se nachází ovládací prvky, baterie a hlavní zdroj.

### 3.3.1 Základna

Základna je ˇcást, která obstarává témˇeˇr veškerou mechaniku joysticku. Je v ní použito pˇet z dvanácti navržených díl ˚u. Hlavní a nejvˇetší díl je díl base.stl, na kterém je položen zbytek joysticku. Tento díl je navržen tak, aby byl schopný spolehlivˇe udržet i hmotnˇejší objekty. To bylo d ˚uležité hlavnˇe z toho d ˚uvodu, že na zaˇcátku vývoje nebylo ještˇe možné odhadnout, jak budou vrchní ˇcásti joysticku vypadat. Bylo tˇreba tedy navrhnout flexibilní spolehlivé ˇrešení. Tato ˇcást v sobˇe obsahuje otvory na pˇrípadné pˇripevnˇení joysticku ke dˇrevˇené desce, pokud se uživateli nezdá samotný joystick dost stabilní (tˇreba na šikmé ploše). Dále má v sobˇe na dva otvory na dvˇe 4mm závitové tyˇce, které lze bezpeˇcnˇe zajistit s pomocí 4 matek. Tyto tyˇce slouží k pˇripevnˇení ˇctyˇr tažných pružin, které zajišt’ují osu Y joysticku ve stˇredové poloze.

Dále jsou na tento díl pˇripevnˇené dvˇe jednoˇradá kuliˇcková ložiska typu 608. Vnˇe tˇechto ložisek je protažená dutá tyˇc o prumˇeru 8mm z jedné strany (použil jsem provrtanou 8mm závitovou

Technická dokumentace

tyˇc) z jedné strany, která je urˇcena k protažení kabel ˚u z potenciometru. Z druhé strany je pˇripevnˇen samotný potenciometr na dílu pot_holder_1.stl, která je k tˇelu pˇrišroubovaný s pomocí dvou malých samoˇrezných šroubk ˚u. K ose otáˇcení musí být pomocí vyˇrezané drážky pˇripevnˇený malý plíšek, aby zajistil otáˇcení potenciometru.

Na celé základnˇe leží díl, který se otáˇcí na ose Y. Tento díl je nejsložitˇejší z celého joysticku. Pˇres nˇej musí být drát protažen ke stranˇe s druhým potenciometrem, který je pˇridˇelaný k tomuto dílu na dílu pot_holder_2.stl, který je znovu zajištˇený s pomocí dvou malých samoˇrezných šroubk ˚u. Dále musí být dráty protažené skrz druhou díru na druhé stranˇe dílu. Tento druhý velký díl také obsahuje dvˇe ˇctyˇrmilimetrové tyˇce, zajištˇené osmi matkami. Ty složí k centrování osy X s pomocí dalších ˇctyˇr tažných pružin, které jsou pˇridˇelané z druhé strany dílu, který je na tento díl položený, a to stirrup.stl. Stirrup je pˇridˇelaný k dílu osy Y pomocí dalších dvou stejných ložisek a 8mm šroubu. Díl je chránˇen pˇred utažením pomocí plíšku, který ale není povinný, ale hodí se k zajištˇení šroubu v jedné poloze. Stejného efektu by mohlo být dosaženo vhodným lepidlem. Šroub z druhé strany také potˇrebuje drážku na plíšek, který otáˇcí potenciometrem. Díl stirrup dále obsahuje 4mm závitovou tyˇc, která je zajištˇena pomocí 8 matek (ˇci více pro stabilnˇejší upevnˇení). Ta slouží k zajištˇení tažných pružin.

Tato ˇcást byla navržena s d ˚urazem na pevnost a robustnost. Je dostateˇcnˇe flexibilní na to, aby pˇrípadnˇe mohla být použita jako základna joysticku jiného projektu.

### 3.3.2 Tˇelo

Tato ˇcást je navržena tak, aby v ní byla uchována hlavní PCB deska, která se používá v tomto projektu. Je tvoˇrena ze dvou díl ˚u. První díl, body.stl, je hlavní strukturní díl této ˇcásti. Druhý díl, body_cover.stl, pro tento díl slouží jako víˇcko. Díl body.stl obsahuje dvˇe hlavní díry na kabely. První díra je ze shora dílu, vede jí naprostá vˇetšina kabel ˚u, které pˇrichází k desce. Proto je její otvor velikostnˇe naddimenzován. Doporuˇcení pˇri skládání je bud’ si kabely nakrimpovat na JST-XH konektory až na konci skládání joysticku, nebo si hotové kabely protáhnout pˇred spojením. Druhá díra slouží k protáhnutí kabel ˚u pˇripojených na potenciometry. Dále je v dílu malý otvor, který by šel použít pro externí led diodu.

Díl je pˇridˇelaný k podstavˇe s pomocí šroubu a matky M8. Hlava joysticku k tomuto dílu pˇridˇelaná pomocí kolejnice a malého samoˇrezného šroubku. Víˇcko je k tomuto dílu pˇridˇelané pomocí ˇctyˇr samoˇrezných šroubk ˚u. Pro pohodlí ruky je vhodné použít šroubky s plochou hlavou.

Tato ˇcást byla navržena tak, aby se do ní vešla nejen deska, ale i množství napojených kabel ˚u a to i s nepˇredvídatelným pˇrebytkem pˇri finálním skládání.

### 3.3.3 Hlava

Poslední ˇcást je sestavena tˇremi díly. Hlavní a nejvˇetší díl je díl head.stl. Ten je navržený tak, aby v sobˇe obsahoval vˇetšinu spoj ˚u, vˇcetnˇe svorkovnice a pomˇernˇe objemného step-up mˇeniˇce MT3608. Zároveˇn se na dílu nachází pˇet z šesti použitých tlaˇcítek KLS7-P8.0X8.0B a joystick KY-023, který je zajištˇený samostatným dílem mini_joystick_holder.stl. S tímto dílem se nepracovalo dobˇre, jelikož rozmˇery KY-023 nejsou dostateˇcnˇe upˇresnˇeny. Na tomto modulu je pramálo symetrického, tudíž

Technická dokumentace

bylo potˇreba zkoušet nˇekolik pokus ˚u a hodnˇe pˇremˇeˇrovat. Pˇri koupi tohoto modulu doporuˇcuji zkontrolovat, jestli pˇresnˇe pasuje hlava joysticku, jelikož odhaduji, že nˇekdy m ˚uže mít jiné rozmˇery.

Poslední díl, který je na hlavˇe joysticku, je díl head-cover.stl. Ten obsahuje BH-421-3A držák baterií na 2 tužkové AAA baterie. Dále je na modulu kolébkový spínaˇc SMRS-101-1C3-B, ke kterému je pˇripojen jeden pól baterií. Dále jsou dráty napojené na step-up mˇeniˇc. Na tomto dílu se zároveˇn nachází poslední, šesté, tlaˇcítko. Díl se dá jednoduše zajistit s pomocí dvou zácvak ˚u na spodní stranˇe dílu a v pˇrípadˇe potˇreby i šroubem na horní stranˇe hlavy. Všechna tlaˇcítka, vˇcetnˇe joysticku a dílu mini_joystick_holder.stl, jsou navržena tak, aby šla jednoduše s trochou opatrnosti z joysticku ruˇcnˇe ˇci kleštˇemi vysunout. Díly se takto nejen snadno montují, ale jdou i snadno opravit, ˇci vymˇenit.

## 3.4 Návod

Použití herního joysticku by mˇelo být docela jednoduché. Nejprve je tˇreba ovˇeˇrit, že zaˇrízení, ke kterému chceme joystick pˇripojit, disponuje technologií Bluetooth a je schopné používat Bluetooth HID.

Dále je tˇreba si ovˇeˇrit operaˇcní systém poˇcítaˇce, ke kterému se joystick pˇripojuje. Joystick by mˇel spolehlivˇe fungovat na sytémech s operaˇcním systémem GNU/Linux. Systém by nemˇel mít pˇríliš zastaralý kernel, ale pokud to nebude v rámci nˇekolika let, tak by to nemˇel být velký problém. Joystick byl spolehlivˇe testován na distribuci Manjaro. Dále by mˇel systém fungovat na systémech Windows 10 a Windows 11. Na nich je tˇreba ovˇeˇrit, že jsou na zaˇrízení nainstalované ovladaˇce DirectX a to od verze devˇet, která obsahují balíˇcky xinput1_3.dll a novˇejší xinput1_4.dll.

Po této kontrole je obsluha joysticku již jednoduchá:

1. Ovˇeˇrit si, že jsou v joysticku dvˇe AAA baterie.
2. Zapnout joystick pˇrepínaˇcem na zadní ˇcásti dílu head_cover.stl
3. Najít zaˇrízení s názvem Flight Stick mezi dostupnými zaˇrízeními.

Pˇripojení joysticku a funkce joysticku lze na systému GNU/Linux ovˇeˇrit pomocí nástroje evtest. Na systému Windows 10 lze pˇripojení ovˇeˇrit v nastavení zaˇrízení a tiskárny, které se nachází v ovládacím panelu.

Pro rychlé testování stavu os a tlaˇcítek lze využít na obou platformách stránku https://hardwaretester.

com/gamepad. (https://hardwaretester.com/gamepad)

Zaˇrízení by mˇelo být ve službˇe Steam viditelné v nastavení jako t0116 a mˇelo by jít jednoduše nastavit ve funkce Steam Input pro vˇetšinu videoher. Pro videohry, které ˇreší zacházení s herními ovladaˇci samy, doporuˇcuji ve službˇe Steam funkci Steam Input vypnout.

Gamepad byl úspˇešnˇe testován na videohˇre Arma III a ve videohˇre Broforce.

# Závˇer

Projekt se zamˇeˇril na návrh a realizaci bezdrátového herního joysticku, který funguje jako HID zaˇrízení a je urˇcen pro domácí výrobu. Výroba takového joysticku vyžadovala vytvoˇrit návrh soustavy elektronických zaˇrízení, jako jsou ovládací prvky a napájení. Vytvoˇrit PCB desku s vhodným mikrokontrolerem a sepsat k nˇemu vhodný program a vymyslet finální mechaniku joysticku a jeho vzhled. Dále byla souˇcástí práce nemálo nároˇcna sestava tˇechto prvk ˚u do finálního produktu.

V rámci projektu byly splnˇeny hlavní cíle, jako je vývoj funkˇcního ovládacího rozhraní, vytvoˇrení funkˇcní elektronické soustavy a vytvoˇrení vhodné PCB desky a také zajištˇení bezdrátového spojení s poˇcítaˇcem. Na druhou stranu se projekt odklonil od cíle vytvoˇrit externí USB zaˇrízení s pˇrijiíma-
ˇcem. Rešení založené na ESP ˇ | 32S3 s pomocí Bluetooth HID se pˇreci odklonilo od p ˚uvodního plánu,
ale prokázalo se jako funkˇcnˇejší, praktiˇctˇejší a efektivnˇejší, než p ˚uvodní návrh. Zárovˇeˇn také snížilo cenu výroby.

Rovnˇež sestava podstavy joysticku nedosáhla oˇcekávané jednoduchosti, což naznaˇcuje prostor pro budoucí zlepšení mechanického designu. Nyní tato ˇcást obsahuje nˇekteré prvky, které je tˇreba vyrobit složitˇeji doma, jako plíšky napojené na ptenciometry. To nic nemˇení na to, že je základna robustní a její sestava není pˇriliš složitá.

Finální produkt také dle mých cíl ˚u není pˇríliš nákladný a ostaní ˇcásto joysticku jsou na sestavení ještˇe výraznˇe jednodušší, než základna.

Joystick by šel nadále vylepšit tˇreba pˇridáním dˇeliˇce napˇetí na desku, což by zajistilo bezpeˇcné ˇctení hodnoty výstpního napˇetí na bateriích. Dále by stálo za to pˇridat externí LED indikátor pro zjištˇení stavu joysticku. Co se týˇce softwaru, ˇrešení je nyní docela jednoduché. Šlo by pˇridat funkce pro napˇríklad vypnutí joysticku pˇri neaktivitˇe. Knihovna ESP32-BLE-Gamepad umožˇnuje také posílání dat z poˇcítaˇce do joysticku, což by šlo využít k jednoduché zmˇenˇe nastavení, která nyní nelze dˇelat jinak, než pˇreprogramovat chip.

# Seznam použité literatury

[Cam25] Dean Camera. LUFA - the Lightweight USB Framework for AVRs. Accessed: 2025-

03-03. 2025. url: https://github.com/abcminiuser/lufa.

[Hei25] | Matthew Heironimus. Arduino Joystick Library. Accessed: 2025-03-03. 2025. url: https://github.com/MHeironimus/ArduinoJoystickLibrary.
[rdb25] | rdbeerman. Joystick-Gimbal. Accessed: 2025-03-03. 2025. url: https://github. com/rdbeerman/Joystick-Gimbal. (https://github.com/rdbeerman/Joystick-Gimbal)
[Sta25] | Tom Stanton. Tom Stanton Engineering. Accessed: 2025-03-03. 2025. url: https: //www.youtube.com/tomstantonengineering.
[tai25] | taifur. DIY Wireless Joystick (Wireless Gaming). Accessed: 2025-03-03. 2025. url: https : / / www . instructables . com / DIY - Wireless - Joystick - Wireless - Gaming/. (https://www.instructables.com/DIY-Wireless-Joystick-Wireless-Gaming/)

# Seznam obrázk ˚u

3.1 | popis zapojení USB s pomocí regulátoru napˇetí dle dokumentace V-USB | | 11
3.2 | popis zapojení USB v datasheetu ATmega32U4 | | 13
