TommanCZ/herni-joystick/models/body.stl

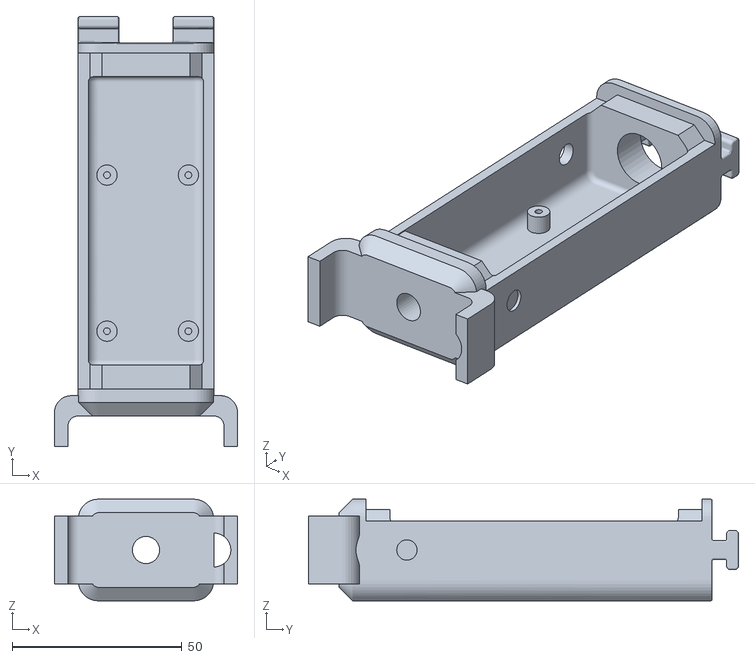
[picture p5: CAD file, 2025-03-02]
models/body.stl
54.0 x 126.7 x 30.0
