TommanCZ/herni-joystick/models/head_cover.stl

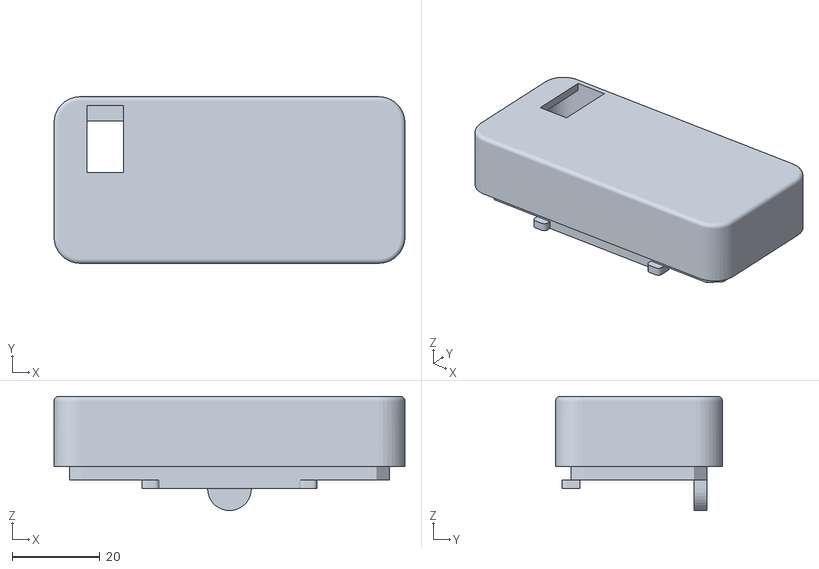
[picture p6: CAD file, 2025-03-02]
models/head_cover.stl
80.0 x 38.0 x 26.0
