TommanCZ/herni-joystick/models/pot_holder_1.stl

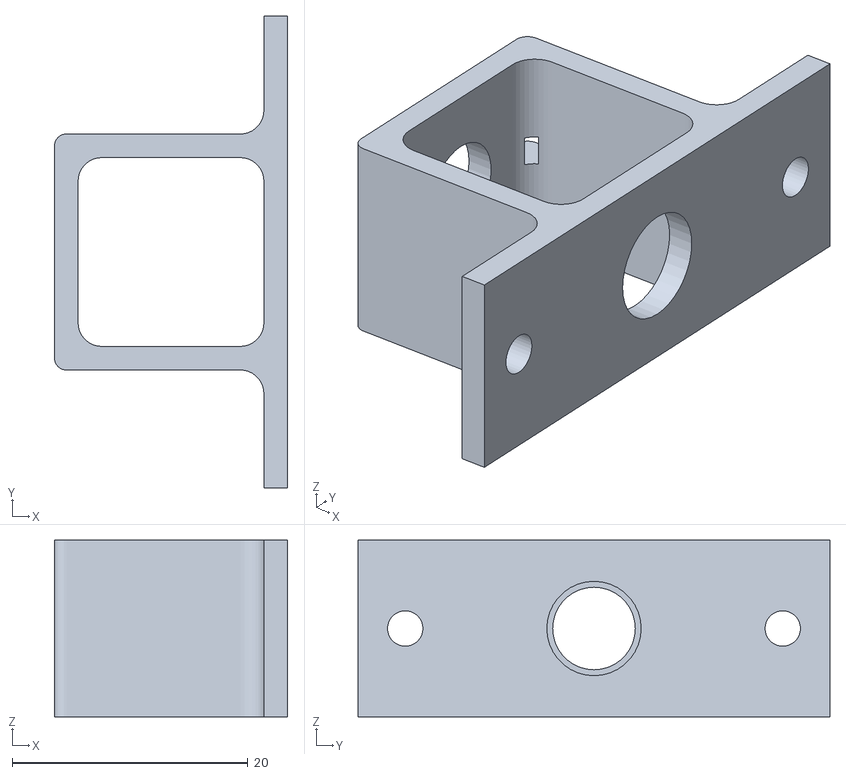
[picture p7: CAD file, 2025-03-02]
models/pot_holder_1.stl
19.8 x 40.0 x 15.0
