TommanCZ/herni-joystick/models/body_cover.stl

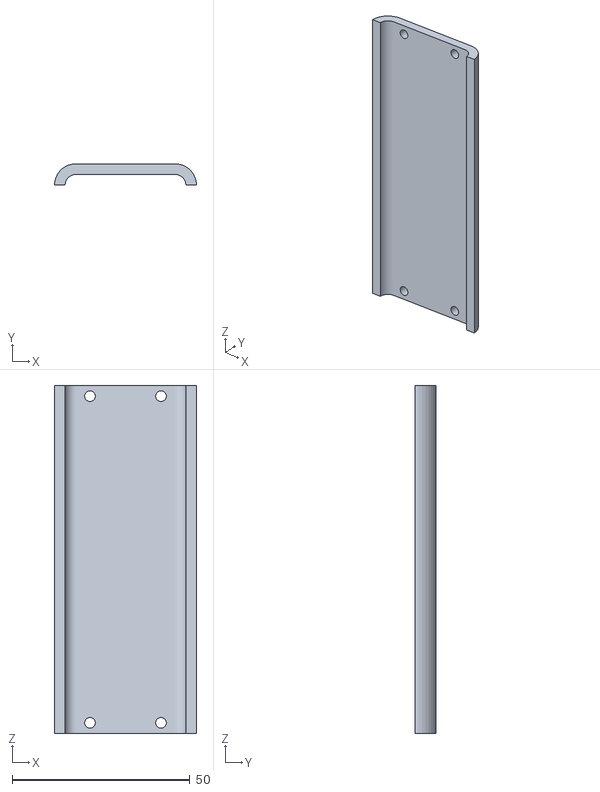
[picture p8: CAD file, 2025-03-02]
models/body_cover.stl
40.0 x 6.00 x 98.0
