TommanCZ/herni-joystick/models/button.stl

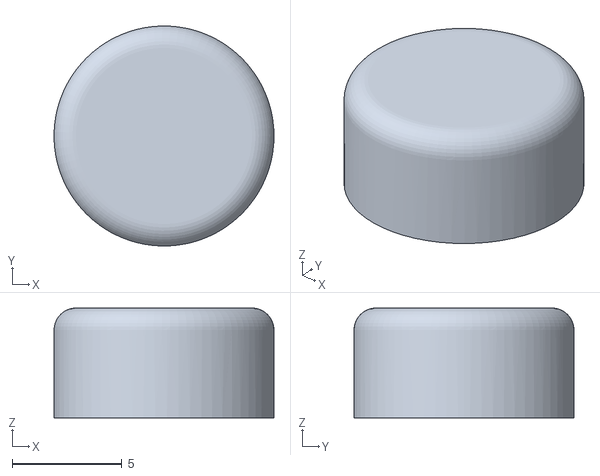
[picture p9: CAD file, 2025-03-02]
models/button.stl
10.0 x 10.00 x 5.00
