TommanCZ/herni-joystick/models/stirrup.stl

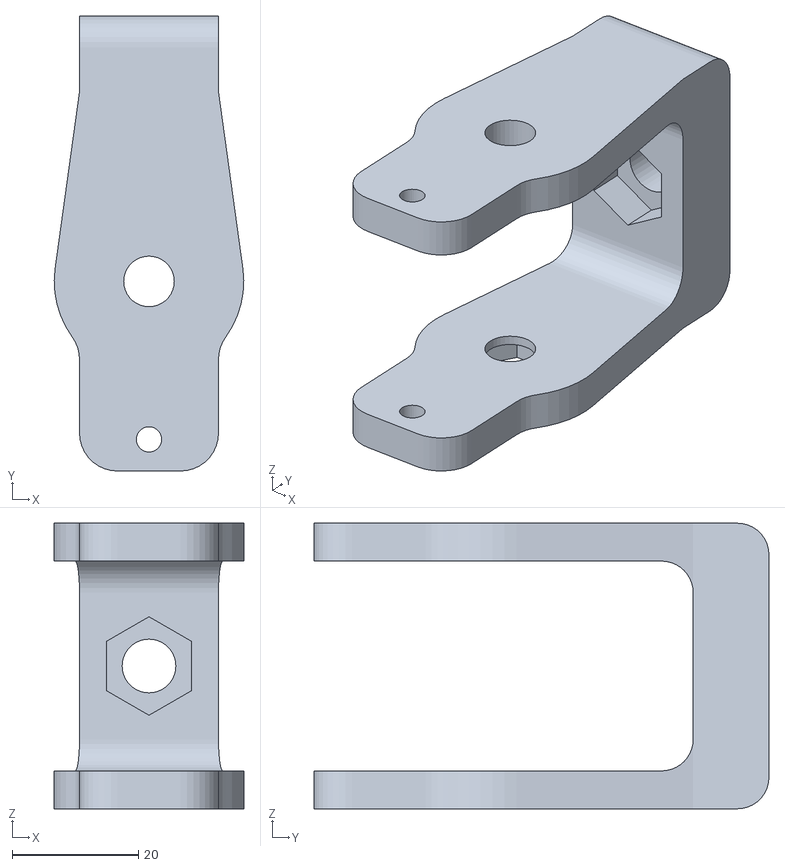
[picture p10: CAD file, 2025-03-02]
models/stirrup.stl
30.0 x 72.0 x 45.2
