TommanCZ/herni-joystick/models/head.stl

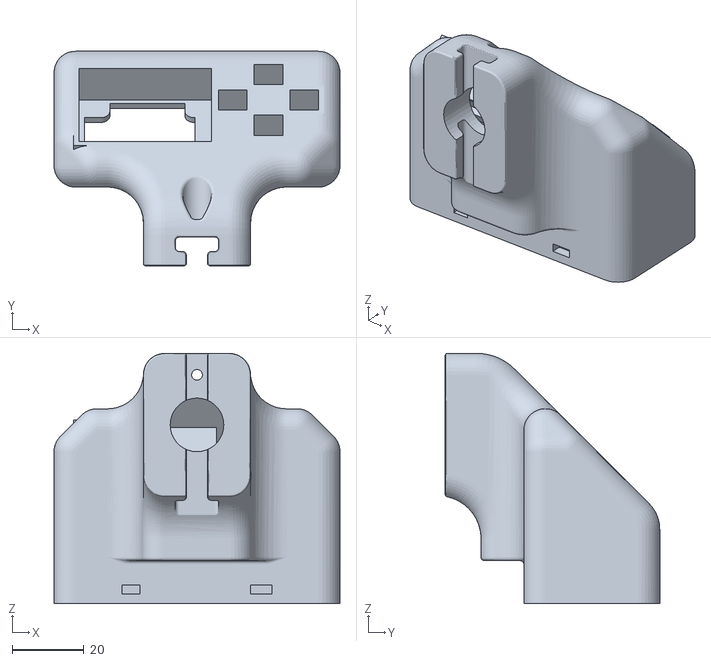
[picture p11: CAD file, 2025-03-02]
models/head.stl
80.0 x 60.0 x 70.0
