TommanCZ/herni-joystick/models/mini_joystick_holder.stl

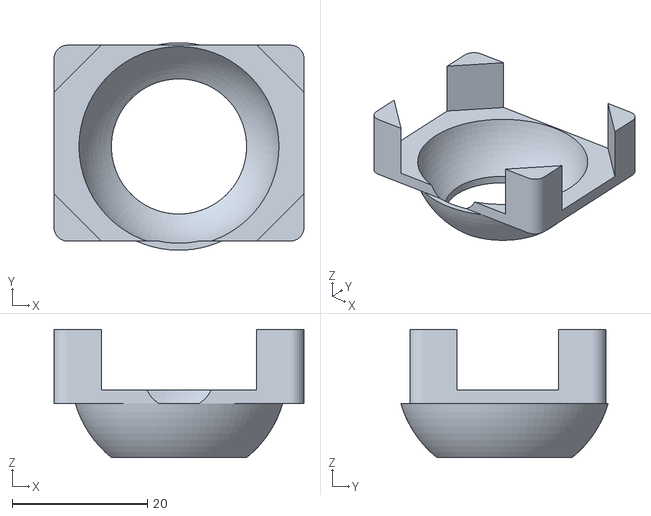
[picture p12: CAD file, 2025-03-02]
models/mini_joystick_holder.stl
37.0 x 30.7 x 19.0
