TommanCZ/herni-joystick/models/pot_holder_2.stl

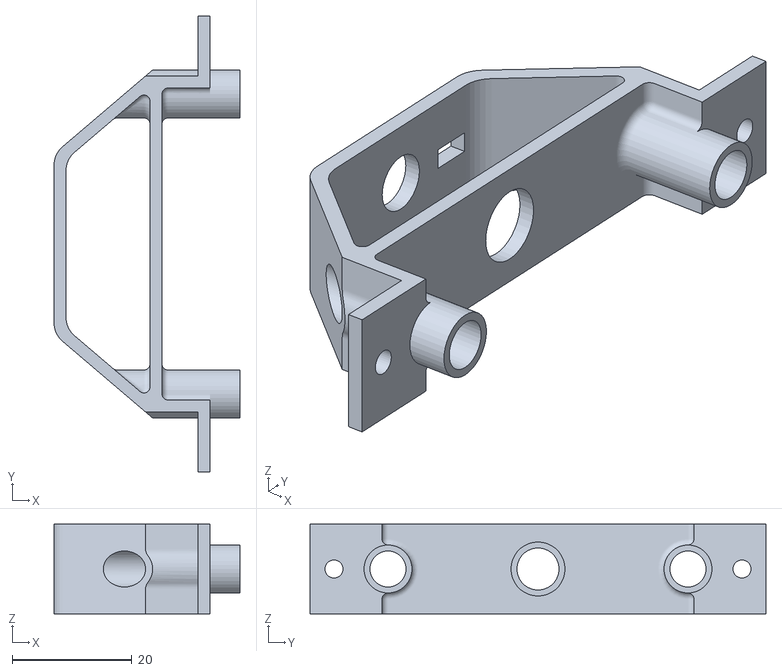
[picture p13: CAD file, 2025-03-02]
models/pot_holder_2.stl
31.0 x 76.0 x 15.0
