TommanCZ/herni-joystick/models/base.stl

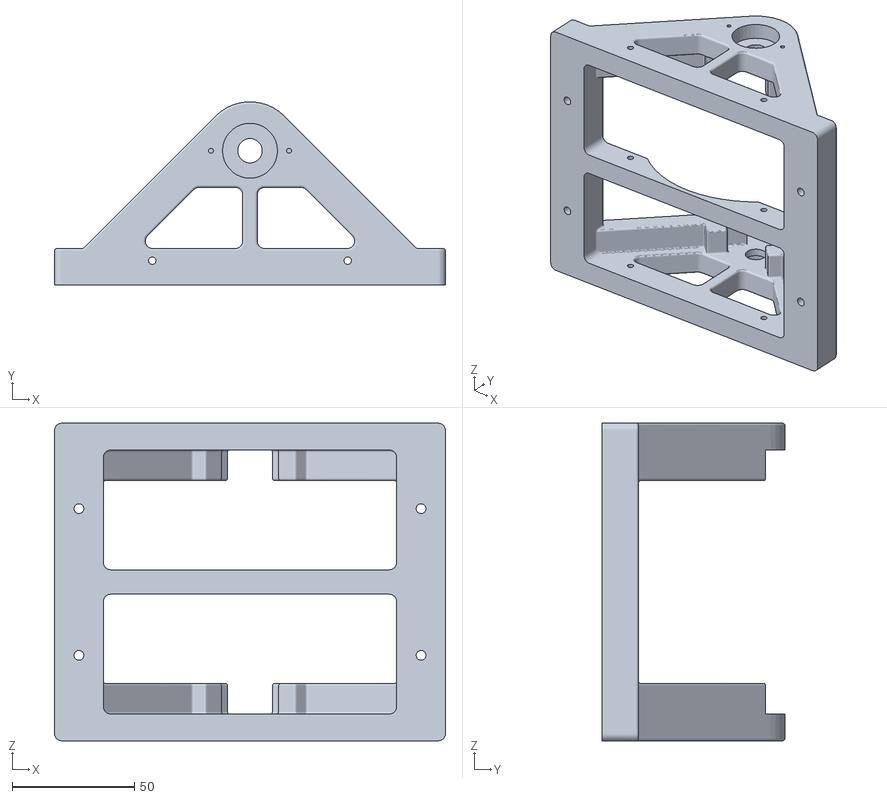
[picture p14: CAD file, 2025-03-02]
models/base.stl
160.0 x 75.0 x 130.0
