TommanCZ/herni-joystick/models/base_axis_part.stl

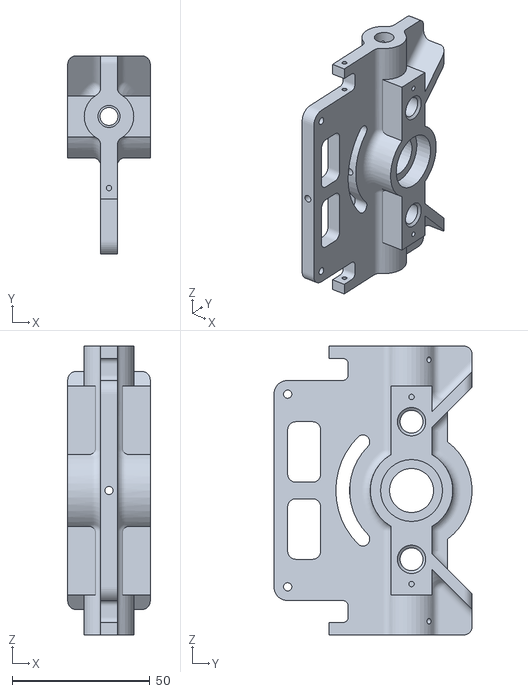
[picture p15: CAD file, 2025-03-02]
models/base_axis_part.stl
30.0 x 72.0 x 105.0
