TommanCZ/herni-joystick/(list of files, drawings)

Other design files:
hardware/joystick_board_esp32/joystick_board_esp32_2025-03-03.epro
hardware/joystick_board_old/ProPrj_SCH_usb_board_2025-02-15.epro
hardware/usb_board/328p_old/SCH_usb_board.json
