TommanCZ/herni-joystick/(commit log)

2025-01-10 Rearranged the usb_board structure repaired bugs in usb_board main.cpp and added main.hex
    [main.cpp]
2025-01-15 Added easyEDA cicuit file with partly finished LDO design
    [SCH_usb_board_2025-01-15.json]
2025-01-16 added connections to nrf24l01 to the easyeda file and changed its name
    [SCH_usb_board.json, SCH_usb_board_2025-01-15.json]
2025-01-21 Added Arduino and nrflite library to the joystick board folder
2025-01-22 rewrote the joystick_board.ino into a .cpp file usingmainly the avr libs instead of arduino core
2025-01-24 changed the crystal design and added the disconect pin for v-sub in SCH_usb_board.json
    [SCH_usb_board.json]
2025-01-25 changed DF_CPU to 8MHz from 16MHz in build.sh
    The 8MHz would be easier to implement since I do not need to add any
    external crystal to the joystick board. Also this way I do not need to
    change the voltage to 5V (because higher freq values like 16MHz require
    higher voltage than 3.3V).
2025-01-25 changed pin numbers of CE and CSN pin to not overlap with the button pins
2025-01-30 added control leds, corrected iverted detection of buttons thanks to pullup and removed serial communication
    [main.cpp]
2025-02-10 added easyeda file for the current joystick board design
    [SCH_joystick_board_2025-02-11.json]
2025-02-10 Old design with atmega328p proved as a bad developement path. This is just an organizing commit.
    [SCH_usb_board.json]
2025-02-12 added usb board design with atmega32u4
2025-02-12 changed the pins according to the latest schematic and removed debug led code
2025-02-15 added files for the most recent version of the joystick_board
    [ProPrj_SCH_usb_board_2025-02-15.epro, SCH_joystick_board_2025-02-11.json]
2025-02-16 updated joystick gerber file
2025-02-16 added gerber file for the usb board 32u4 variant
2025-02-24 Added ide file for the new esp32 bluetooth solution
2025-02-24 corrected syntax mistakes, added extended button feature, simplified configuration in joystick.ide
2025-02-25 added STL parts files for printing, deleled Joystick.STEP since it is outdated and not convinient
    [body.stl, body_cover.stl, button.stl, button_holder.stl, head.stl, head_cover.stl, mini_joystic_holder.stl]
2025-02-25 added Gerber file for the final board - esp32s3 board that will utilise esp32 bluetooth capabilities, renamed old board to old
    [ProPrj_SCH_usb_board_2025-02-15.epro]
2025-02-27 added base parts and resolved misspelled name of mini_joystick_holder
    [base.stl, base_axis_part.stl, mini_joystic_holder.stl, mini_joystick_holder.stl, pot_holder_1.stl, pot_holder_2.stl, stirrup.stl]
2025-02-27 updated head parts to fit the mini joystick
    [button.stl, head.stl, head_cover.stl]
2025-03-02 Fixed mistake with boot button connected as always on
2025-03-02 added reverse axis feature and chnaged the configuration to be same as the PCB board pins
2025-03-03 removed unused model
    [button_holder.stl]
2025-03-03 added epro file for the esp32 board
    [joystick_board_esp32_2025-03-03.epro]
